chipdipru/RDC2-0026_usb-programmer-FLASH-EEPROM.-STM32F042F6P6/README.md

<p>USB-программатор предназначен для записи и чтения микросхем памяти серий 24хх, 25хх, 93хх, 95хх. На плате установлена панель для микросхем в корпусе DIP-8, предусмотрены посадочные места для микросхем в корпусах SOIC-8 и SOIC-16 (для серии 25хх). Все необходимые для работы с микросхемами сигналы выведены на разъемы.<br>
Для записи микросхем памяти необходимы файлы формата .bin. Программатор автоматически конвертирует файлы E2Prom.Hex SigmaStudio в .bin для записи.</p>
<p>Характеристики<br>
поддерживаемые серии микросхем памяти: 24хх, 25хх, 93хх, 95хх<br>
поддерживаемые корпуса: DIP-8, SOIC-8, SOIC-16 (для серии 25хх)<br>
максимальная тактовая частота: 24хх – 1 МГц; 25хх / 95хх – 24 МГц; 93хх – 2 МГц<br>
напряжение питания микросхем памяти: 3,3 В<br>
формат файла для записи / чтения: .bin, SigmaStudio .hex<br>
чтение / запись регистра состояния микросхем памяти<br>
хранение шаблонов микросхем памяти в формате .txt</p>
