chipdipru/RDC2-0026_usb-programmer-FLASH-EEPROM.-STM32F042F6P6/RDC2_0026_VS_project/RDC2_0026/images/RDC2-0026_SPI_SOIC_16.png

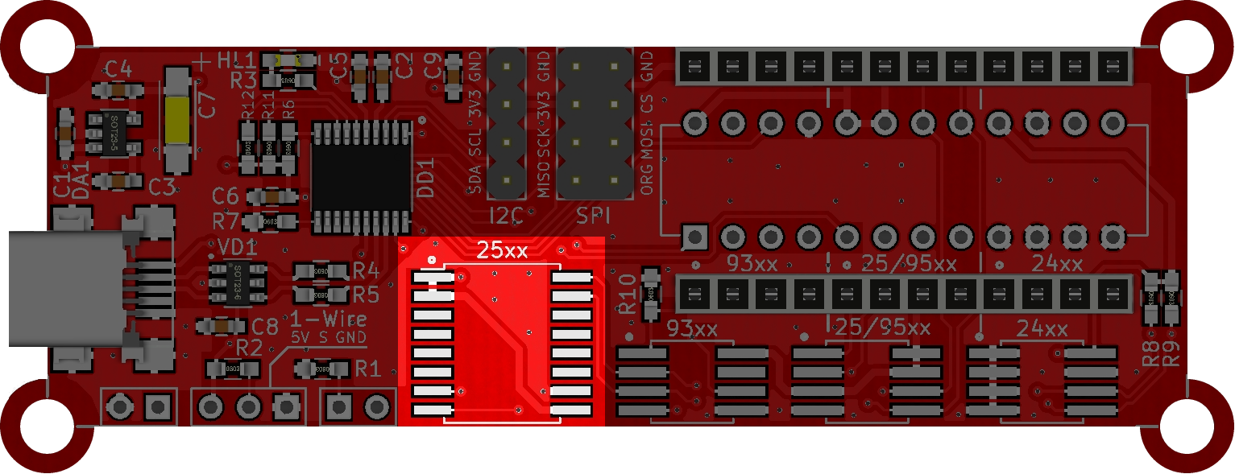
RDC2_0026_VS_project/RDC2_0026/images/RDC2-0026_SPI_SOIC_16.png
