chipdipru/RDC2-0026_usb-programmer-FLASH-EEPROM.-STM32F042F6P6/RDC2-0026_BOM.pdf

RDC2-0026 BOM

количество | позиция | наименование | код товара
2 | C1, C4 | 4.7 мкФ Y5V 10% 10В 0603 | 9000103929
5 | C2, C5, C6, C8, C9 | 0.1мкФ,Y5V 50В, 20%,0603 | 226236018
1 | C3 | 0.01 мкФ,Y5V 50В,+80-20%,0603 | 990818187
1 | C7 | 10 мкФ, 10 В, тип A, 10% | 868717967
1 | DD1 | STM32F042F6P6 | 9000329866
1 | DA1 | LP2985AIM5-3.3/NOPB | 398602252
1 | HL1 | KP-1608MGC (зеленый) | 939848017
6 | R1, R6, R7, R10 - R12 | 0.063Вт 0603 10 кОм, 5% | 65097
1 | R2 | 0.063Вт 0603 4.7 кОм, 5% | 13832
1 | R3 | 0.063Вт 0603 390 Ом, 5% | 44261
2 | R4, R5 | 0.063Вт 0603 22 Ом, 5% | 45498
2 | R8, R9 | 0.063Вт 0603 3.3 кОм, 5% | 64985
1 | VD1 | USBLC6-2SC6 | 9000039051
1 | XS1 | MiniUSB-A | 587420270
3 | | PLS-4 | 174993133
1 | | SCS-24 (DS1009-24AN), DIP панель
| | 24 контакта узкая | 62963
1 | | Печатная плата RDC2-0026 | 9000421060
