chipdipru/RDC2-0026_usb-programmer-FLASH-EEPROM.-STM32F042F6P6/RDC2-0026_sch.pdf

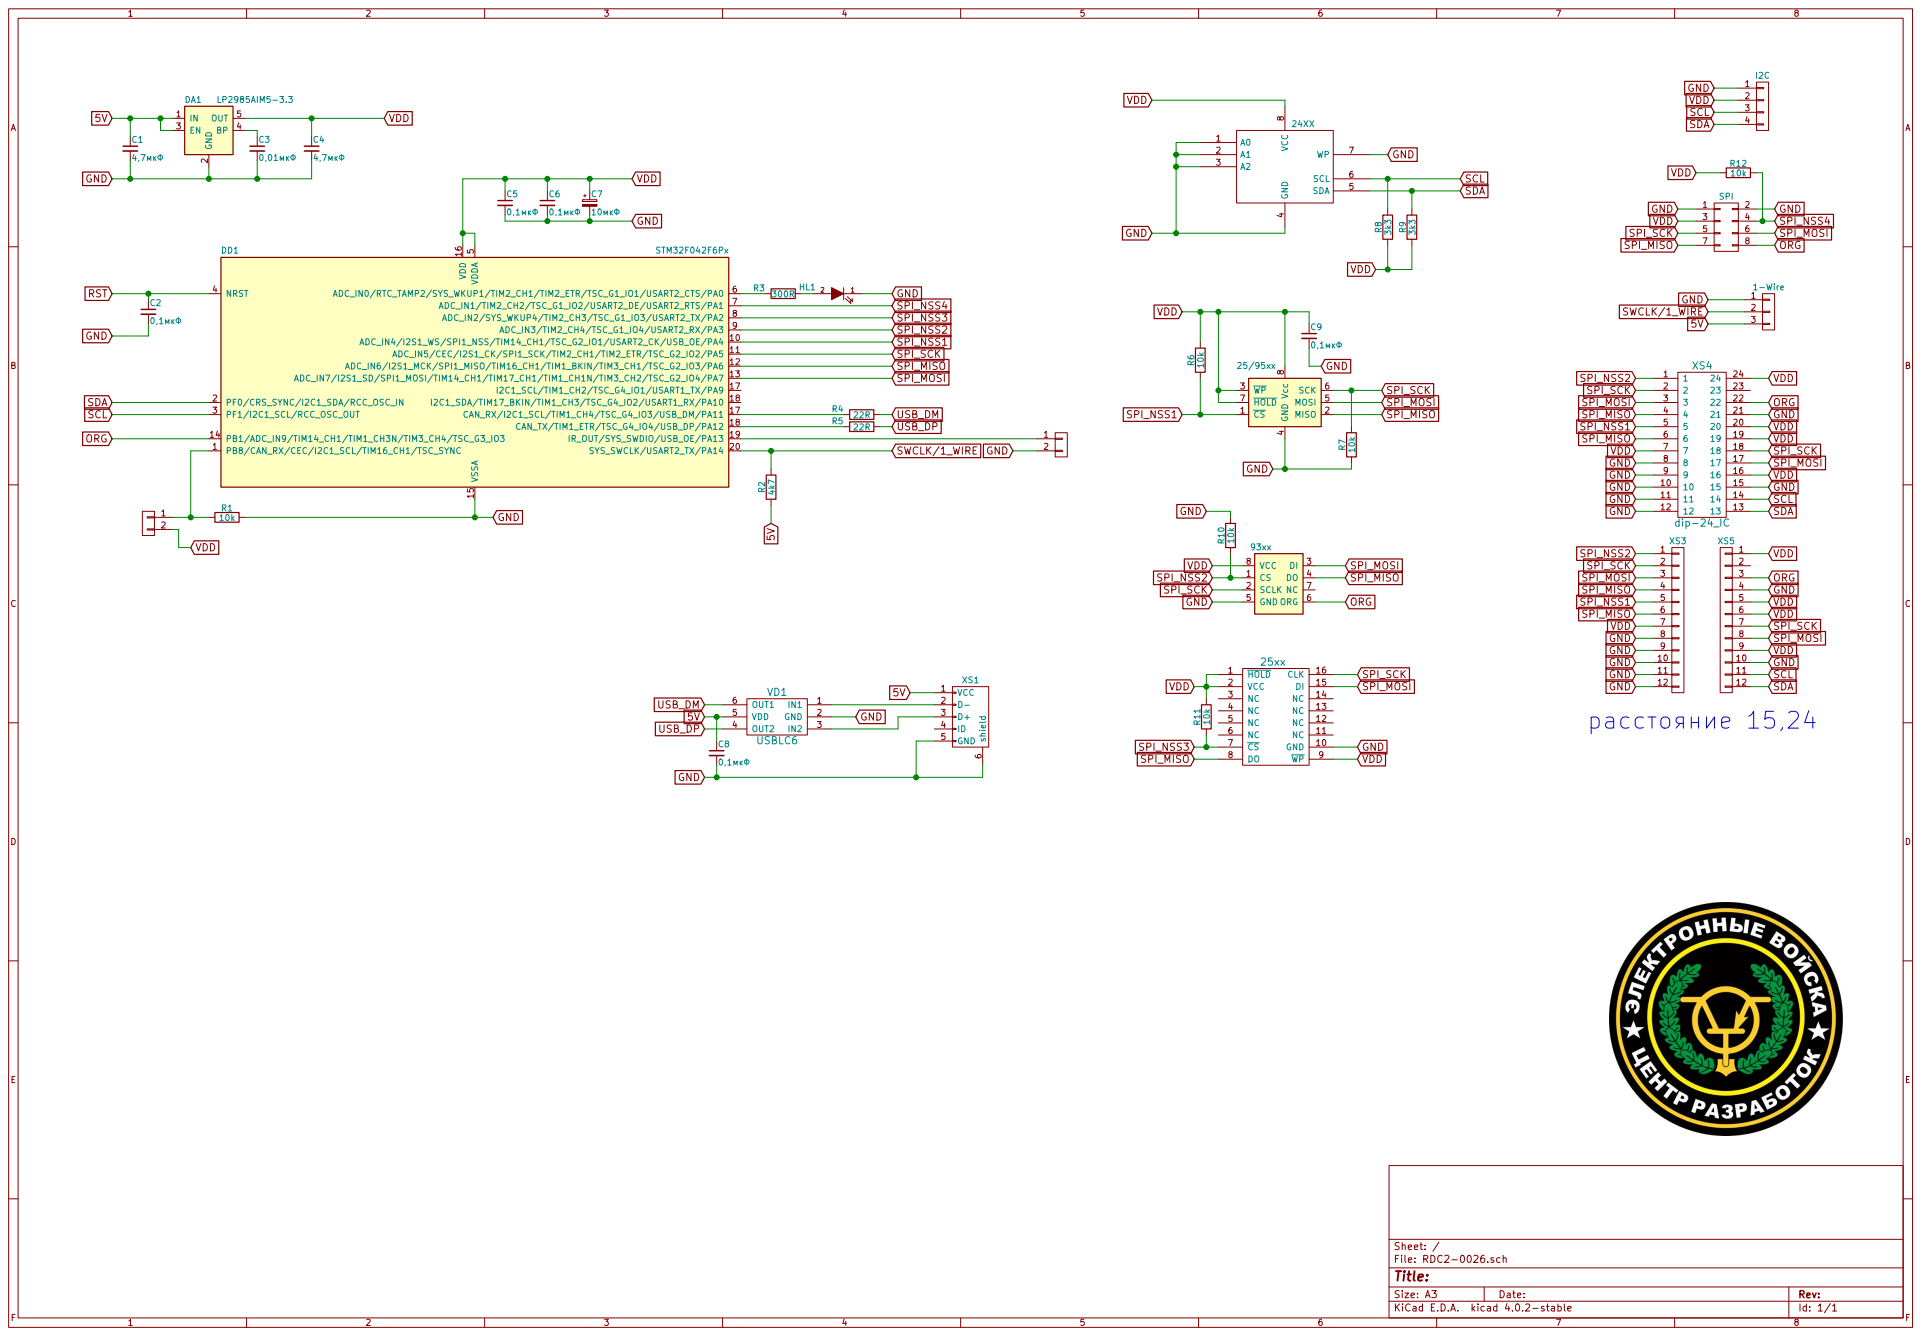
[picture p13: page 1]

2 EN 3 BP 4 OUT 5 DA1 LP2985AIM5-3.3 GND

4 MOSI 5 SCK 6 HOLD 7 Vcc 8

Id: 1/1 Title: File: RDC2-0026.sch Sheet: /
