chipdipru/RDC2-0026_usb-programmer-FLASH-EEPROM.-STM32F042F6P6/RDC2-0026_KiCAD_project/RDC2-0026.kicad_pcb

## KiCad design RDC2-0026_KiCAD_project/RDC2-0026.kicad_pcb (2018-09-18)

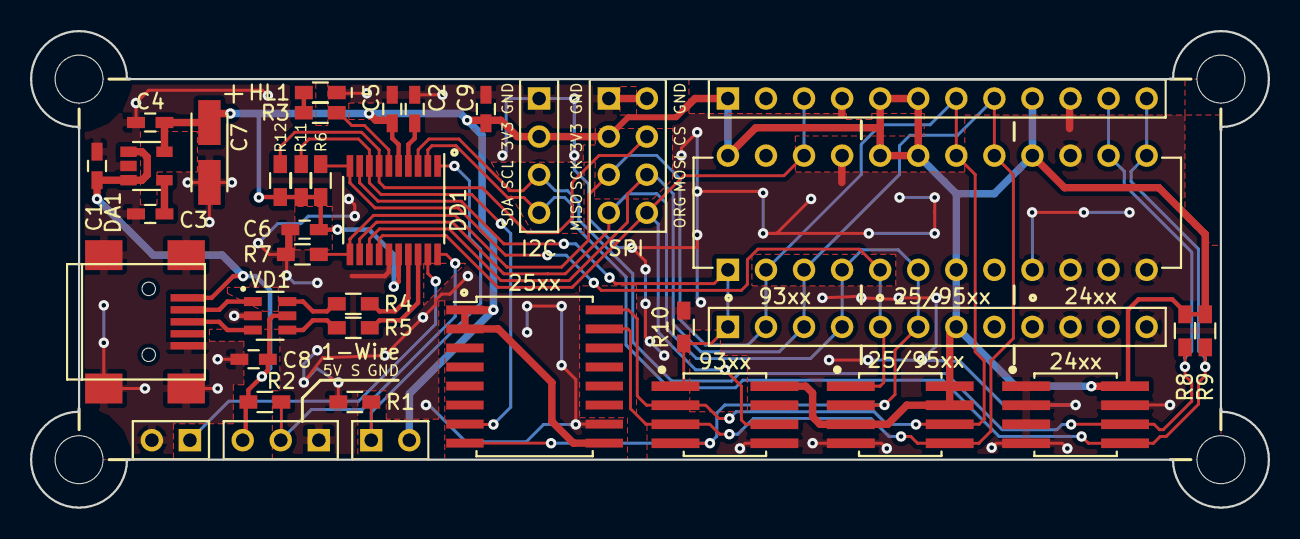
[picture p14: board RDC2-0026.kicad_pcb from above]

Board: 2 copper layers, 82.6 x 31.8 mm, 38 parts (0 on the bottom side), 26 nets.

Parts:
24xx: 24XX EEPROM; SOIC-8_combo_Pitch1.27mm
25/95xx: 25LC_EEPROM; SOIC-8_combo_Pitch1.27mm
25xx: 25xx_spi_flash; SOIC-16_7.5x10.3mm_Pitch1.27mm_long_pads
93xx: 93LCxxC; SOIC-8_combo_Pitch1.27mm
C1, C4: 4,7мкФ; C_0603_HandSoldering
C2, C5, C6, C8, C9: 0,1мкФ; C_0603_HandSoldering
C3: 0,01мкФ; C_0603_HandSoldering
C7: 10мкФ; TantalC_SizeA_EIA-3216_HandSoldering_mm
DA1: LP2985AIM5-3.3; SOT-23-5_mm
DD1: STM32F042F6Px; TSSOP-20_4.4x6.5mm_Pitch0.65mm
HL1: LED; LED_0603_HandSoldering
R1, R6, R7, R10, R11, R12: 10k; R_0603_HandSoldering
R2: 4k7; R_0603_HandSoldering
R3: 300R; R_0603_HandSoldering
R4, R5: 22R; R_0603_HandSoldering
R8, R9: 3k3; R_0603_HandSoldering
VD1: USBLC6; SOT23-6L
XP1, XP4: PLS-2; Pin_Header_Straight_1x02_mm
XP3: CONN_01X04; Pin_Header_Straight_1x04_mm
XP5: CONN_02X04; Pin_Header_Straight_2x04_mm
XS1: USB_OTG; USB_Mini-B_mm
XS2: CONN_01X03; Pin_Header_Straight_1x03_mm
XS3, XS5: CONN_01X12; Pin_Header_Straight_1x12_mm
XS4: dip-24_IC; DIP-24_W7.62mm_0.9x1.5

Connections:
5V: C1.1, C8.1, DA1.1, DA1.3, R2.1, VD1.5, XS1.1, XS2.3
GND: 24xx.1, 24xx.2, 24xx.3, 24xx.4, 24xx.7, 25/95xx.4, 25xx.10, 93xx.5, C1.2, C2.2, C3.2, C4.2, C5.2, C6.2, C7.2, C8.2, C9.2, DA1.2, DD1.15, HL1.1, R1.2, R7.1, R10.2, VD1.2, XP3.1, XP4.2, XP5.1, XP5.2, XS1.5, XS1.6, XS2.1, XS3.8, XS3.9, XS3.10, XS3.11, XS3.12, XS4.8, XS4.9, XS4.10, XS4.11, XS4.12, XS4.15, XS4.21, XS5.4, XS5.10
unnamed: C3.1, DA1.4
unnamed: DD1.1, R1.1, XP1.1
unnamed: DD1.6, R3.1
unnamed: DD1.17, R4.1
unnamed: DD1.18, R5.1
unnamed: DD1.19, XP4.1
unnamed: HL1.2, R3.2
unnamed: VD1.1, XS1.2
unnamed: VD1.3, XS1.3
ORG: 93xx.6, DD1.14, XP5.8, XS4.22, XS5.3
RST: C2.1, DD1.4
SCL: 24xx.6, DD1.3, R8.2, XP3.3, XS4.14, XS5.11
SDA: 24xx.5, DD1.2, R9.2, XP3.4, XS4.13, XS5.12
SPI_MISO: 25/95xx.2, 25xx.8, 93xx.4, DD1.12, XP5.7, XS3.4, XS3.6, XS4.4, XS4.6
SPI_MOSI: 25/95xx.5, 25xx.15, 93xx.3, DD1.13, XP5.6, XS3.3, XS4.3, XS4.17, XS5.8
SPI_NSS1: 25/95xx.1, DD1.10, R6.1, XS3.5, XS4.5
SPI_NSS2: 93xx.1, DD1.9, R10.1, XS3.1, XS4.1
SPI_NSS3: 25xx.7, DD1.8, R11.1
SPI_NSS4: DD1.7, R12.2, XP5.4
SPI_SCK: 25/95xx.6, 25xx.16, 93xx.2, DD1.11, R7.2, XP5.5, XS3.2, XS4.2, XS4.18, XS5.7
SWCLK/1_WIRE: DD1.20, R2.2, XS2.2
USB_DM: R4.2, VD1.6
USB_DP: R5.2, VD1.4
VDD: 24xx.8, 25/95xx.3, 25/95xx.7, 25/95xx.8, 25xx.1, 25xx.2, 25xx.9, 93xx.8, C4.1, C5.1, C6.1, C7.1, C9.1, DA1.5, DD1.5, DD1.16, R6.2, R8.1, R9.1, R11.2, R12.1, XP1.2, XP3.2, XP5.3, XS3.7, XS4.7, XS4.16, XS4.19, XS4.20, XS4.24, XS5.1, XS5.5, XS5.6, XS5.9
