chipdipru/RDC2-0026_usb-programmer-FLASH-EEPROM.-STM32F042F6P6/RDC2-0026_IAR_project/Src/DataTables.c

/*
********************************************************************************
* COPYRIGHT(c) ЗАО «ЧИП и ДИП», 2017
* 
* Программное обеспечение предоставляется на условиях «как есть» (as is).
* При распространении указание автора обязательно.
********************************************************************************
*/


#include "RDC2_0026_board.h"


const uint32_t I2C_TIMINGR[] = 
{
   0xB0420F13, //100 кГц @ 48 MHz
   0x50330309, //400 кГц @ 48 MHz
   0x50100103, //1 МГц @ 48 MHz
};

const uint16_t I2C_TIMER_PCS[] = 
{
   12000, //100 кГц 
   3000, //400 кГц 
   2000, //1 МГц @ 
};


const uint8_t SPI_CHIP_SEL_OUT[] =
{
  1 << SPI_NSS1_PIN, //25xx/95xx soic-8, DIP-8
  1 << SPI_NSS2_PIN, //93xx soic-8, DIP-8
  1 << SPI_NSS3_PIN, //25xx soic-16
  1 << SPI_NSS4_PIN, //SPI connector
};
