chipdipru/RDC2-0026_usb-programmer-FLASH-EEPROM.-STM32F042F6P6/(commit log)

2018-09-18 USB программатор FLASH и EEPROM. STM32F042F6P6
2018-09-18 Soft для программирования
    SigmaStudio compatible
2018-09-18 небольшая база микросхем памяти
2018-09-18 Kicad проект платы RDC2-0026
    [RDC2-0026.kicad_pcb, RDC2-0026.sch]
2018-09-18 Руководство пользователя
