chipdipru/RDC2-0026_usb-programmer-FLASH-EEPROM.-STM32F042F6P6/(notices)

Notices in the files:
RDC2-0026_IAR_project/Src/DataTables.c:
COPYRIGHT(c) ÇÀÎ «×ÈÏ è ÄÈÏ», 2017
